doriqu/color-cube-sorter/docs/03-slides/slides.pdf

# CLUB D’INFORMATIQUE INDUSTRIELLE · IGE × EPAC

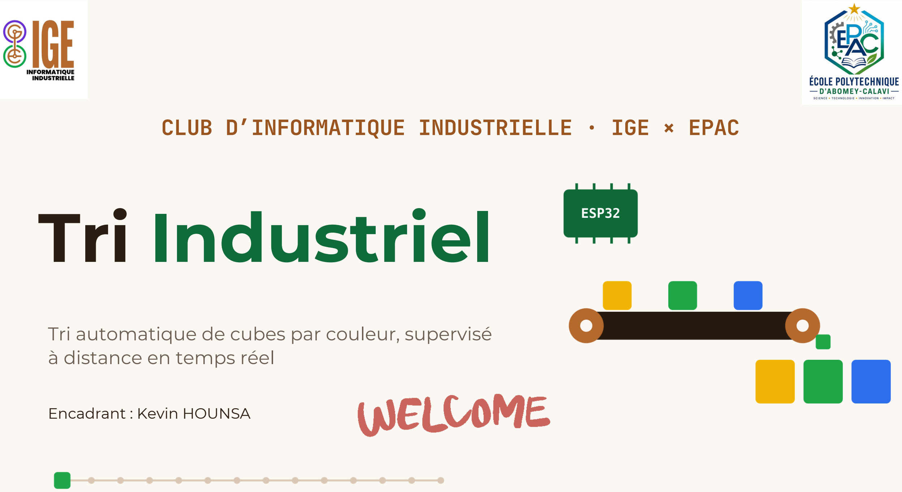
[picture p12: page 1]

### Encadrant : Kevin HOUNSA

# Tri Industriel

## Tri automatique de cubes par couleur, supervisé à distance en temps réel

### 02 · CONTEXTE

# Contexte et problématique

# Trier à la main, c’est lent, fatigant, et on finit par se

tromper.

01

## Sur le terrain

Usines, entrepôts, recyclage : des milliers de pièces à séparer chaque jour.

02

## Le problème

Fatigue, erreurs, cadence irrégulière et aucune traçabilité de la production.

03

## Les conséquences

Pièces mal triées, retards, perte de temps et de qualité.

## Notre défi : trier par couleur sans intervention humaine, et suivre la production à

distance.

IGE × EPAC · 02/15

### 03 · LA RÉALITÉ DU BESOIN

# Des tris où l’humain ne devrait pas être

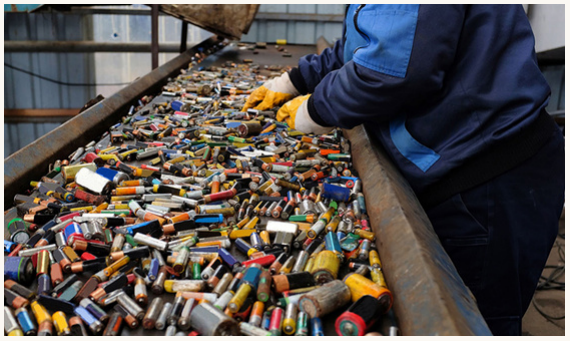
[picture p13: figure]

CHIMIQUE · INCENDIE

### DEEE et batteries au lithium

Intoxication aux métaux lourds (plomb, cadmium, mercure) et risque d’incendie ou d’explosion si une batterie est
endommagée.

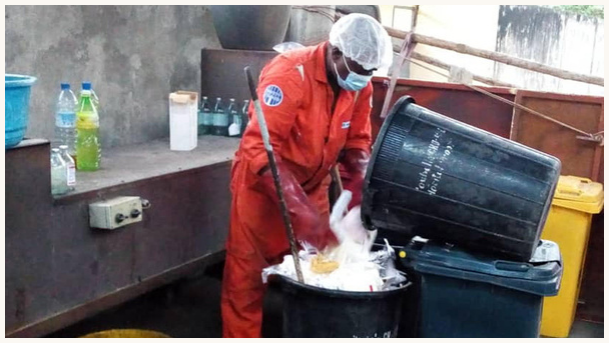
[picture p14: figure]

BIOLOGIQUE

### Déchets biomédicaux

Piqûres et coupures avec des aiguilles et instruments contaminés (VIH, hépatites, bactéries résistantes).

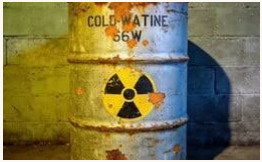
[picture p15: figure]

RADIOLOGIQUE

### Déchets radioactifs

Exposition aux radiations ionisantes : risque cancérigène, voire mortel, malgré une radioprotection stricte.

Un trieur automatique éloigne l’humain du danger.

IGE × EPAC · 03/15

### 04 · OBJECTIFS

# Ce que le système doit accomplir

01

## Trier

Reconnaître jaune, vert et bleu, puis orienter le bac au bon moment.

02

## Protéger

Détecter un cube inconnu et s’arrêter en urgence à tout instant.

03

## Superviser

Compteurs, historique et
graphique en temps réel sur Blynk.

04

## Fiabiliser

Anti-rebond, watchdog et
reprise sans perdre le
comptage.

IGE × EPAC · 04/15

### 05 · FONCTIONNEMENT

# Du cube au bac, étape par étape

### Détection

Le laser de début
repère le cube : il
entre dans la file,
le tapis démarre.

### Identification

L’ultrason le voit, la
caméra capture, le
HSV donne la couleur,
envoyée en UART.

### Transport

Le tapis avance à
vitesse constante,
chaque cube garde
son état.

### Fin de tapis

Le laser de fin
détecte l’arrivée, le
servo oriente le bac.

### Chute

Après un délai
calculé (distance ÷
vitesse), le cube
tombe dans le bon
bac.

### Comptage

Compteurs, dernier
tri et graphique sont
mis à jour sur Blynk.

IGE × EPAC · 05/15

### 06 · COMMUNICATIONS

# Qui parle à qui, et comment

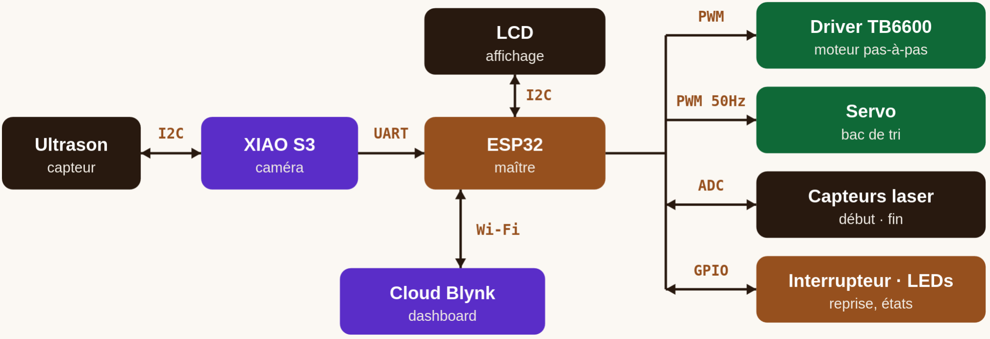
[picture p16: figure]

IGE × EPAC · 06/15

### 07 · MATÉRIEL ET TECHNOLOGIES

# Nos choix, et pourquoi

### ESP32 maître

Double cœur, Wi-Fi, PWM matériel : tri et cloud en parallèle

### XIAO ESP32-S3

Caméra intégrée, format minuscule, dédié à la vision

### Vision HSV

La teinte résiste mieux que le RGB aux variations de lumière

### Moteur + TB6600

Vitesse précise et constante : délai de chute calculable

### Capteurs laser

Détection nette, sans contact, réponse rapide

### Servo 180°

Trois positions fixes, une par bac, commande PWM simple

### Blynk

Dashboard web et mobile prêt à l’emploi, sans serveur à maintenir

Simple, rapide, abordable : chaque choix répond à un besoin précis.

IGE × EPAC · 07/15

### 08 · LOGIQUE LOGICIELLE

# Deux cœurs, zéro blocage

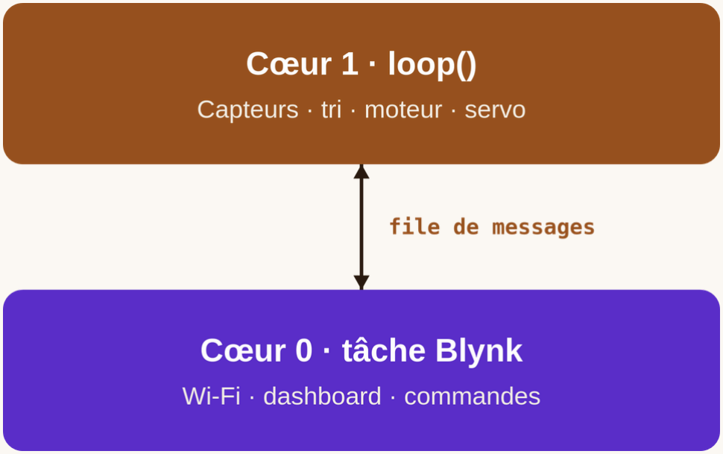
[picture p17: figure]

### File de cubes FIFO

Chaque cube suit sa couleur et l’état du bac.

### Aucun delay()

millis() et anti-rebond logiciel sur chaque capteur.

### Délai de chute calculé

Selon la vitesse du tapis, pour orienter le bac à temps.

IGE × EPAC · 08/15

### 09 · SÉCURITÉS

# Notre priorité

## « Un système sans sécurité n’est pas automatisé : il est hors de contrôle. »

01

### Arrêt d’urgence

Bouton physique ou dashboard : moteur coupé net, LED rouge clignotante.

02

### Reprise contrôlée

Interrupteur ou Play. Les
chronos sont gelés puis
décalés.

03

### Cube inconnu

Tapis stoppé sur le capteur de fin jusqu’au retrait, puis reprise auto.

04

### Watchdog

120 s sans activité : arrêt et réinitialisation du système.

IGE × EPAC · 09/15

### 10 · SUPERVISION

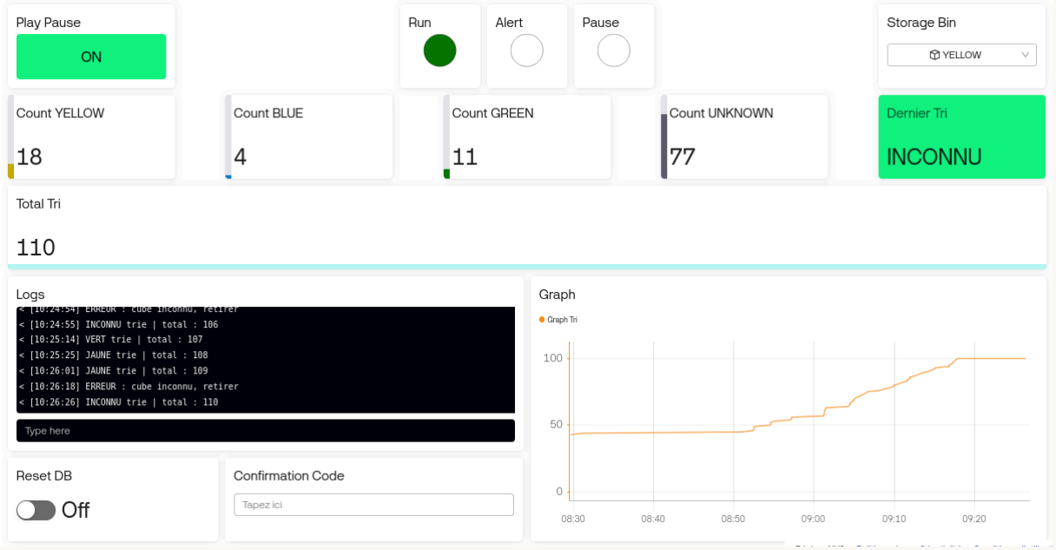
[picture p18: figure]

01

04

### Commandes

Play/Pause, choix du bac, reset par code

IGE × EPAC · 10/15

# Dashboard IoT Blynk

### Suivi

Compteurs par couleur, total, dernier tri

02

### États

LED Marche · Pause · Alerte

03

### Historique

Journal horodaté, cadence par 5 min

### 11 · COMMUNICATION IOT

# Liaison ESP32 ↔ Blynk Cloud

## 3 Clés d'Authentification

Identifiants déclarés en
haut du code pour associer l'ESP32 au template Blynk :

### - BLYNK_TEMPLATE_ID - BLYNK_TEMPLATE_NAME - BLYNK_AUTH_TOKEN

## Broches Virtuelles (V-Pins)

Échange de données bidirectionnel :

### Montante (ESP32 ➔ Cloud / Dashboard) : Fonction : pushInt() ou Blynk.virtualWrite(Pin, valeur)

### Descendante (Cloud / Dashboard ➔ ESP32) : Fonction : BLYNK_WRITE(VirtualPin)

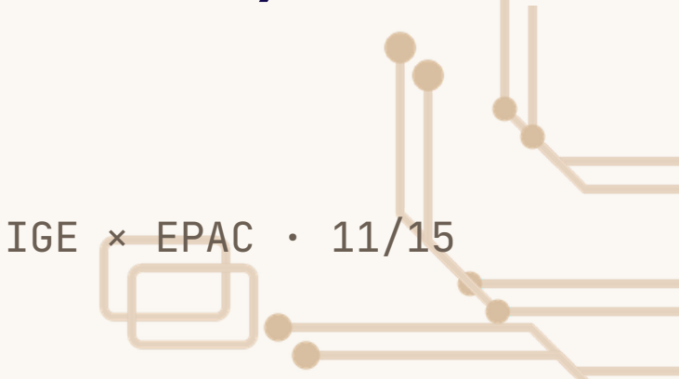
[picture p19: figure]
IGE × EPAC · 11/15

### 12 · RÉSULTATS

# Résultats et démonstration

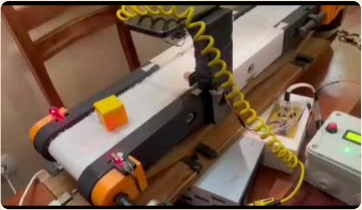
[picture p20: figure]

[__]

cubes par minute

IGE × EPAC · 12/15

[__]

cubes triés
[__]

taux de réussite

### 13 · DIFFICULTÉS

# Ce qui nous a donné du fil à retordre

01

### Câblage fragile

Des fils qui se détachaient et coupaient le circuit. | 02

### Lumière ambiante

Capteurs laser perturbés : faux déclenchements, redémarrages, comptage faussé.

### 03 Cubes trop proches

La caméra voyait deux cubes dans la même image.

### 04 Wi-Fi capricieux

Connexion difficile à établir, latences importantes.
05

### Caméra limitée

XIAO S3 : ~2 MP, sans autofocus, petit capteur. Une caméra classique fait bien mieux.

06

### HSV sensible

Le réglage des teintes dépendait de la luminosité.

Difficulté n°7 : le montage qui marche à la perfection… sauf devant le jury.

IGE × EPAC · 13/15

### 14 · SOLUTIONS

# Comment on les a résolues

Fils qui se détachent | → Colle à chaud sur les connexions, câblage fixé et vérifié
Lumière ambiante | → Éclairage stable et calibrage à chaque nouvel environnement
Faux déclenchements | → Anti-rebond logiciel et détection par front montant
Cubes trop proches | → Espacement minimal de 5 cm : un seul cube dans l’image, bac prêt à temps
Wi-Fi instable | → Le tri continue sans Wi-Fi ; reconnexion auto, compteurs gardés en mémoire
Caméra limitée | → Vision simple en HSV, cube bien centré : le meilleur de ce matériel

IGE × EPAC · 14/15

### 15 · PERSPECTIVES

# Et la suite ?

## Vision

Caméra plus performante, éclairage contrôlé et tri par forme avec OpenCV.

## Capacité

Plus de couleurs, tapis plus rapide, plusieurs bacs.

## Données

Dashboard web hébergé et base cloud (ex. Firebase) pour un historique long, au-delà de Blynk.

# Merci. Place à la démo !

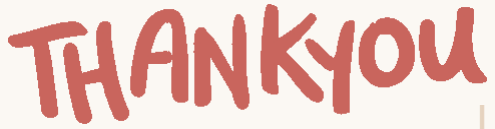
[picture p21: figure]

IGE × EPAC · 15/15
